tobiasvalbjoern/IOT_project/README.md

# IOT_project
This github repository covers the 5th semester IOT project at EDE Herning in the fall by Tobias Valbjørn. It describes the development of a prototype of an IOT pulse measuring device, that can give you a general idea of your fitness level based on your resting heart rate. The project scope and requirements are described in Aarhus University course catalog for the course E5IOT.
