tobiasvalbjoern/IOT_project/Documentation/Diagrams/architecture_IOT_project_vers2 .pdf

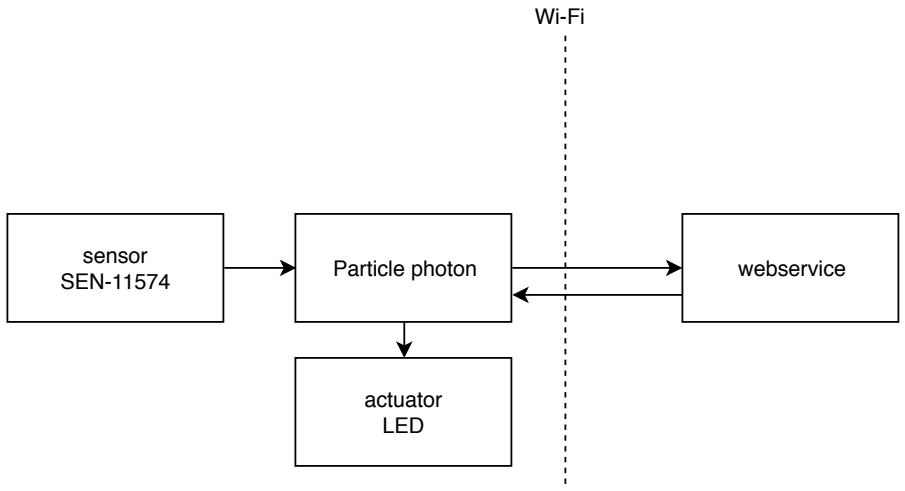
[picture p1: figure]
Particle photon; webservice sensor; SEN-11574; actuator LED
