tobiasvalbjoern/IOT_project/Documentation/Diagrams/flowdiagramPulseIOT.pdf

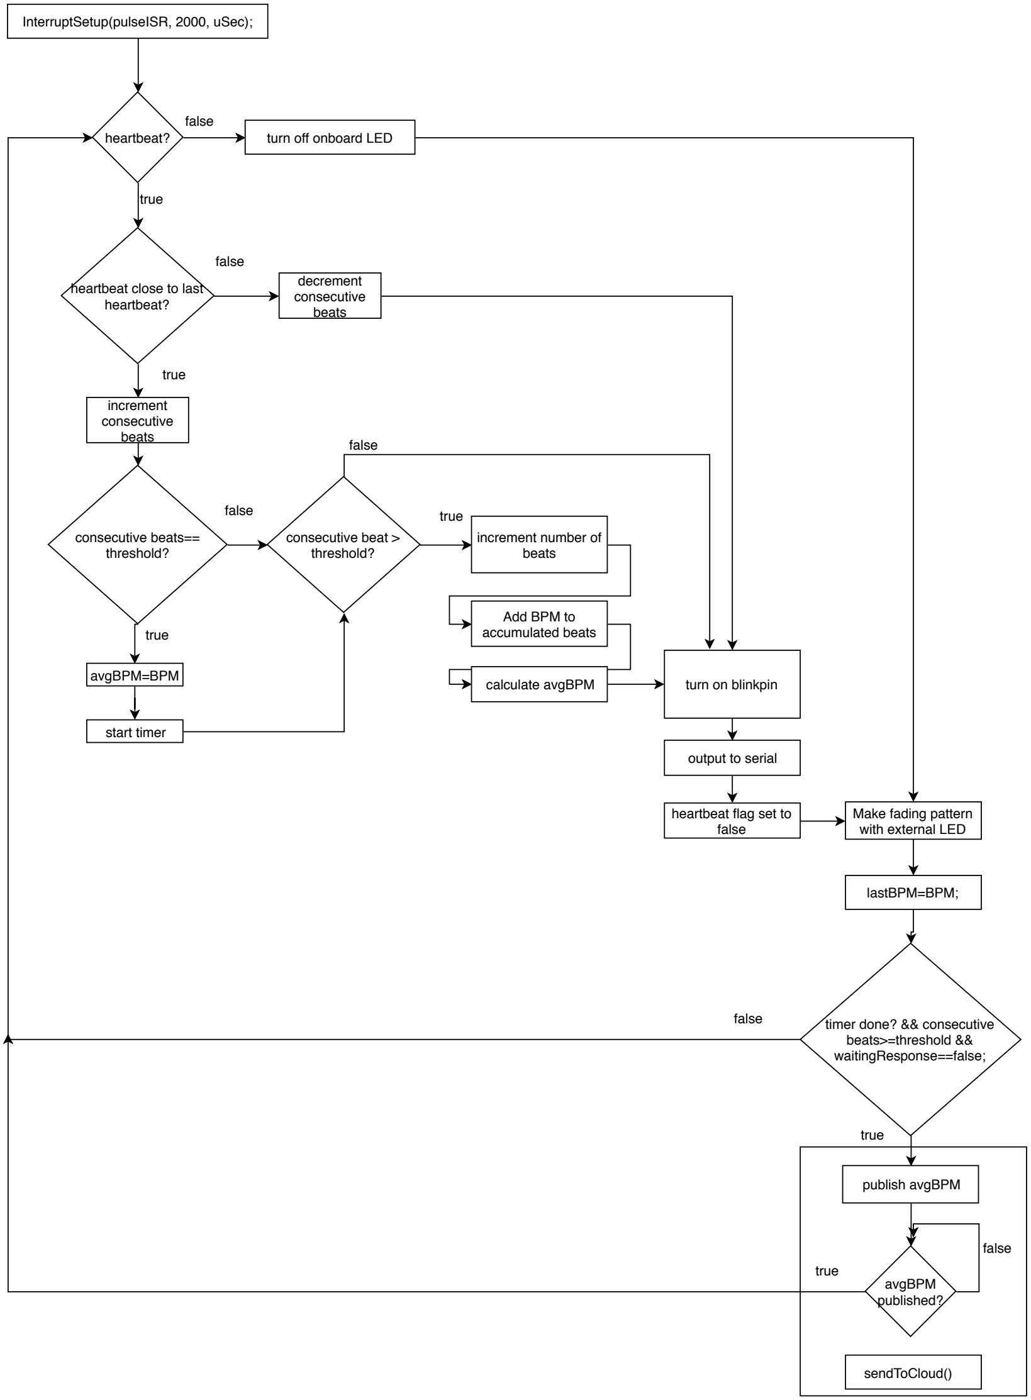
[picture p15: figure]
InterruptSetup(pulseISR, 2000, uSec);; heartbeat?; turn off onboard LED; false; heartbeat close to last heartbeat?; true; increment consecutive beats; consecutive beats== threshold?; start timer; avgBPM=BPM; consecutive beat > threshold?; decrement consecutive beats; increment number of beats; Add BPM to accumulated beats; calculate avgBPM; turn on blinkpin; output to serial; heartbeat flag set to false; Make fading pattern with external LED; lastBPM=BPM;; timer done? && consecutive beats>=threshold && waitingResponse==false;; avgBPM published?; publish avgBPM; sendToCloud()
