tobiasvalbjoern/IOT_project/Documentation/Diagrams/IOTproject_vers2.pdf

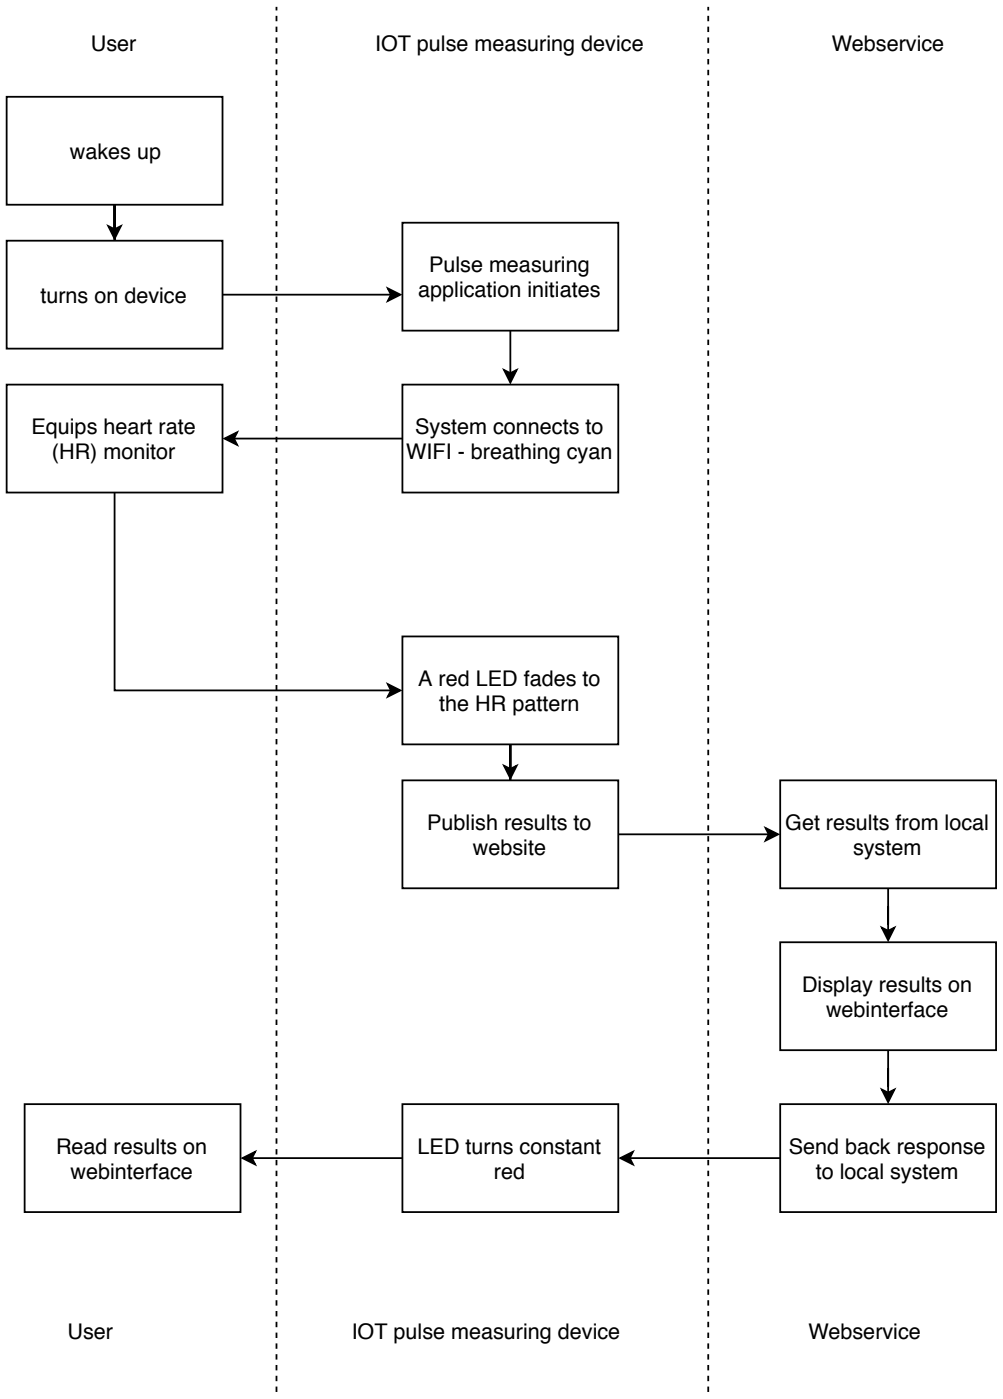
[picture p16: figure]
turns on device; System connects to WIFI - breathing cyan; Pulse measuring application initiates; wakes up; User; IOT pulse measuring device; A red LED fades to the HR pattern; Publish results to website; Webservice; Get results from local system; Display results on webinterface; Send back response to local system; LED turns constant red; Read results on webinterface; Equips heart rate (HR) monitor
