tobiasvalbjoern/IOT_project/Documentation/Diagrams/myHandler.pdf

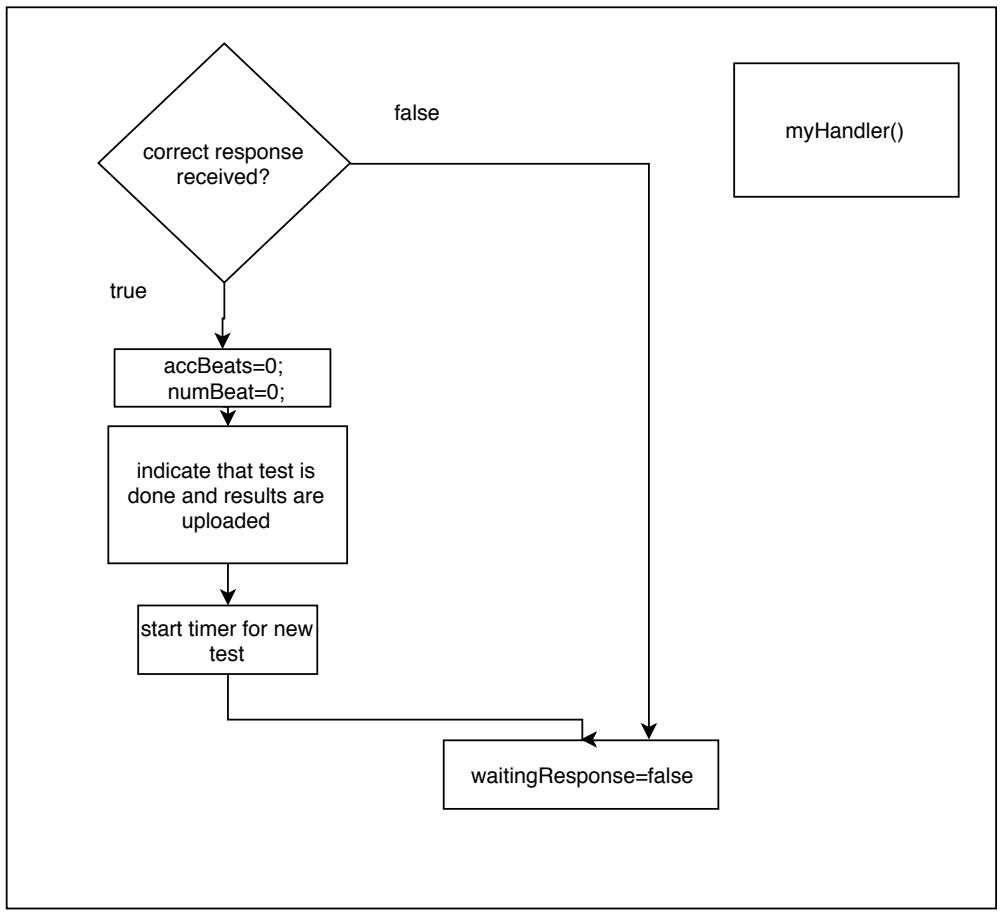
[picture p17: figure]
myHandler(); start timer for new test; indicate that test is done and results are uploaded; waitingResponse=false; correct response received?; false; true; accBeats=0; numBeat=0;
