tobiasvalbjoern/IOT_project/(commit log)

2018-10-09 Added code. It can show BPM. The fade pin needs to be tested.
2018-10-11 After 10 consecutive beats close to each other, the test will automatically initiate. It will start to calculate an average resting heart rate. When the test is done a function will be called, where 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
